jwoc101/Semaforo-Vehicular-y-Peatonal/diagramas/Diagrama_reloj_555.pdf

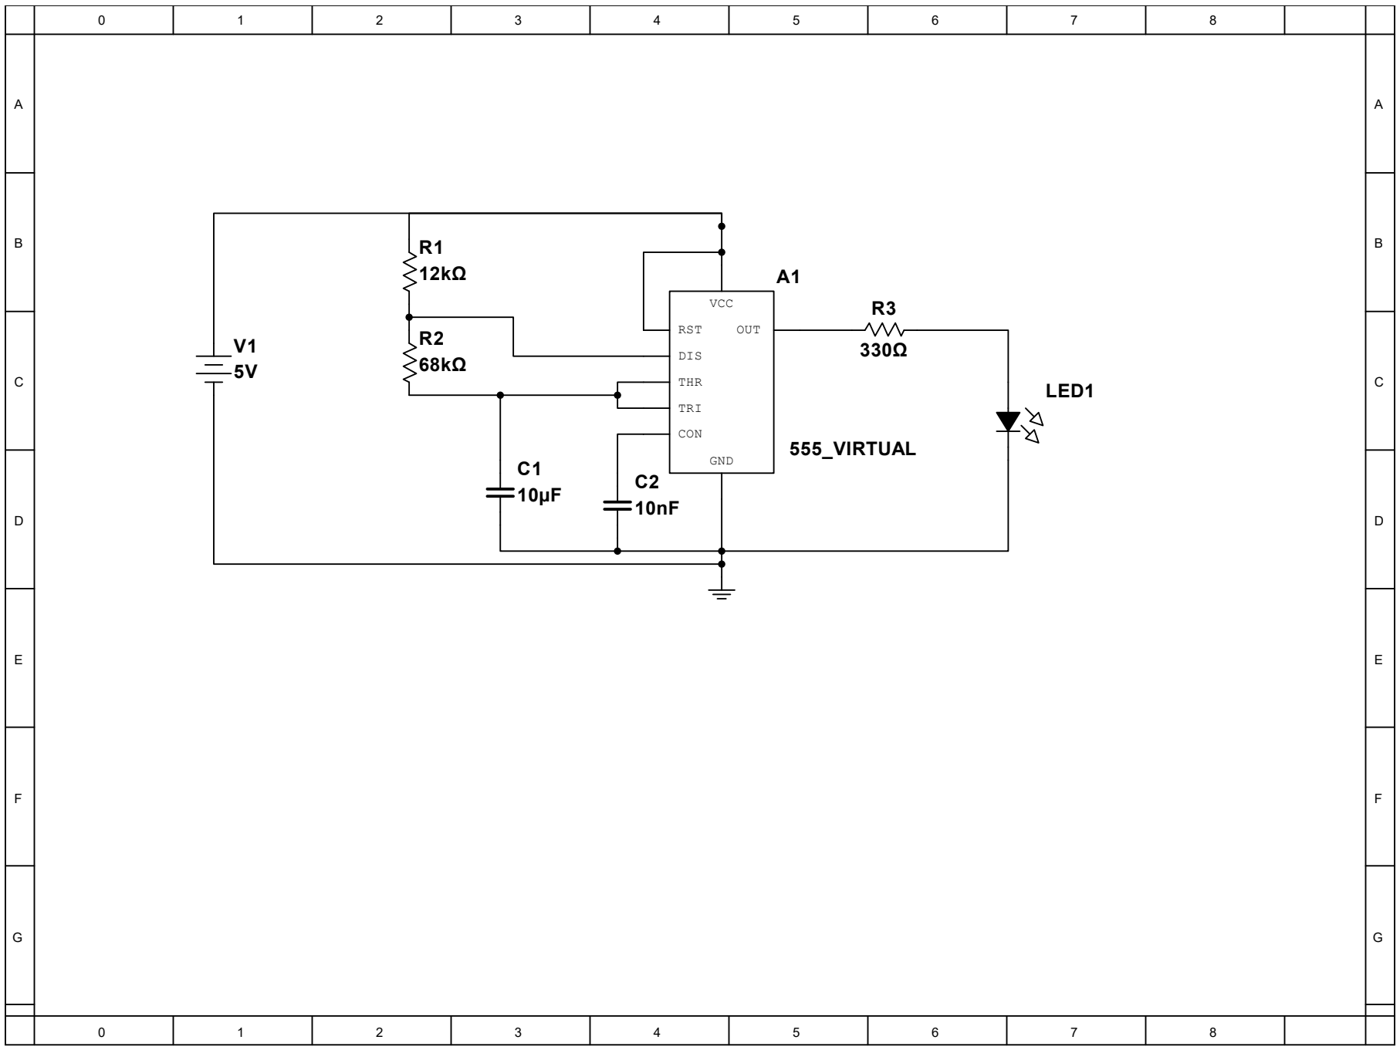
[picture p33: figure]
555_VIRTUAL; GND; DIS; RST; OUT; VCC; THR; CON; TRI; LED1
