jwoc101/Semaforo-Vehicular-y-Peatonal/Informe_Diseño/Informe_Diseño1.pdf

EL3215 LABORATORIO DE ELECTRÓNICA ANALÓGICA, IS2026 | 1

# Proyecto Final: Semáforo Vehicular y Peatonal

### Gabriel Alonso Chavarría Rodríguez José Andrés Guerrero Araya Julián Murillo Wo Ching Jimena Vargas Vega

Resumen

Resumen del proyecto.

Index Terms

Semáforo, FSM, temporización, lógica digital, electrónica analógica.

I. INTRODUCCIÓN
Texto de introducción.

II. PROPUESTA DE DISEÑO
II-A. Subsistema de Control y Temporización
II-A1. Reloj con Temporizador 555: Para el funcionamiento adecuado del sistema de control, y en general del proyecto, se requiere una señal de reloj que permita establecer una referencia de tiempo para los contadores y la máquina de estados. Por esta razón, se diseñó un circuito basado en el temporizador 555 en configuración astable, ya que esta configuración permite generar una señal cuadrada periódica sin necesidad de una señal externa de disparo.
La frecuencia de oscilación del 555 en modo astable se aproxima mediante [2]:

f =

1,44
(RA + 2RB)C

(1)

El objetivo fue obtener una frecuencia cercana a 1 Hz, de manera que cada ciclo de la señal represente aproximadamente un segundo dentro del sistema. Inicialmente se seleccionaron valores comerciales para las resistencias y el capacitor, y posteriormente se ajustó el valor de RA para acercar la frecuencia al valor deseado.
Los valores utilizados fueron:
RA = 12 kΩ
RB = 68 kΩ
C = 10 µF
Sustituyendo estos valores en la ecuación:

f =

1,44
(12kΩ + 2(68kΩ))(10µF)

(2)

f ≈ 0,973 Hz | (3)

Por lo tanto, el período aproximado es:

T =

1
f
≈ 1,03 s | (4)

Este valor se considera adecuado para la propuesta de diseño, ya que se encuentra cercano a 1 Hz y permite utilizar la salida del 555 como reloj base del sistema. La salida del temporizador se conecta a un LED únicamente como indicador visual durante la simulación (Figura 1).

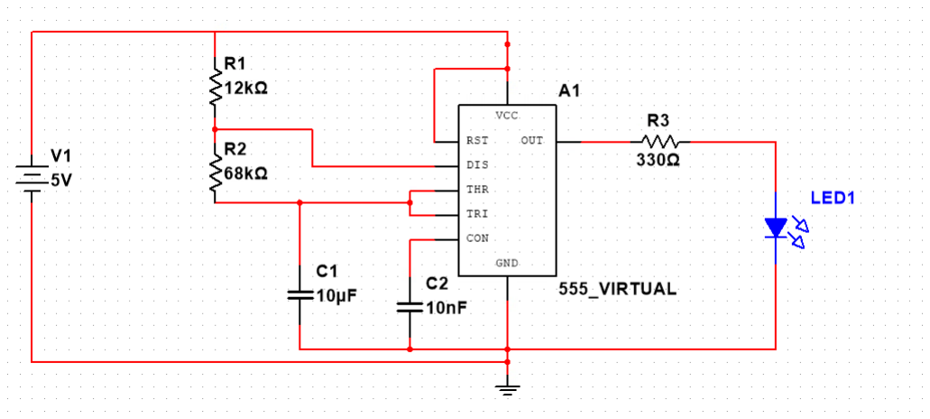
[picture p34: figure]

Figura 1. Circuito del reloj de aproximadamente 1 Hz implementado con temporizador 555 en configuración astable.

II-A2. Botón y Antirrebote: El botón peatonal funciona como la entrada principal externa hacia el sistema de control. Básicamente su activación acciona toda la lógica de ambos semáforos y sistemas asociados por medio de la máquina de estados. Sin embargo, los pulsadores mecánicos pueden generar rebotes no deseados durante su accionar, provocando así múltiples transiciones rápidas aunque solo se haya presionado el botón una vez. Para evitar que la máquina de estados interprete una sola pulsación como varias solicitudes, se implementó un circuito de antirrebote. El circuito utiliza una red RC formada por una resistencia de pull-down y un capacitor conectado a tierra. Esta red suaviza las variaciones rápidas producidas por el rebote mecánico del pulsador. Los valores seleccionados fueron:
R = 10 kΩ
C = 100 nF
La constante de tiempo de la red RC se calcula como:
τ = RC | (5)

Sustituyendo los valores utilizados:

τ = (10kΩ)(100nF) | (6)
τ = 1 ms | (7)

Posteriormente, la señal pasa por dos inversores Schmitt Trigger del circuito integrado 74LS14D (Figura 2). El primer inversor convierte la señal suavizada en una señal digital estable, mientras que el segundo inversor se utiliza para recuperar la polaridad original. De esta forma, la salida final, denominada BTN_CLEAN, toma un valor lógico alto cuando el botón es presionado y un valor lógico bajo cuando se encuentra liberado. En resumen, este módulo genera una salida llamada BTN_CLEAN que será usada a partir de ahora para referirse a la señal limpia del botón.

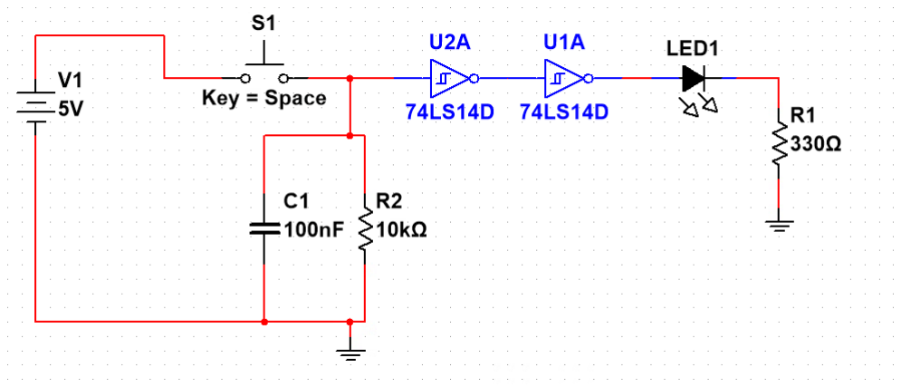
[picture p35: figure]

Figura 2. Circuito de entrada del botón peatonal con red RC y compuertas Schmitt Trigger.

II-A3. FSM: Texto.
II-A4. Memoria del botón: La memoria del botón surge a partir de una consideración importante del sistema: ¿qué ocurre si el botón peatonal se presiona mientras el semáforo ya se encuentra en media secuencia? Para evitar que una nueva pulsación altere el funcionamiento del sistema en la máquina de estados, se decidió que el botón solamente debe ser aceptado cuando la misma s se encuentra en el estado inicial S0, ya que solamente aquí habría una necesidad real de cruzar.
La codificación de estados considerada para la máquina de estados es la siguiente:

Cuadro I
CODIFICACIÓN DE ESTADOS DE LA FSM.
Estado | Q1 | Q0
S0 | 0 | 0
S1 | 0 | 1
S2 | 1 | 0
S3 | 1 | 1

Como el único estado en el que se desea aceptar el botón es S0, se implementó una señal de habilitación llamada S0_ACTIVE. Esta señal debe ser igual a 1 únicamente cuando Q1 = 0 y Q0 = 0. Para lograr esto se utilizó una compuerta NOR 74LS02, ya que:

S0_ACT IV E = Q1 + Q0 | (8)

De esta forma, cuando el sistema se encuentra en S0, la salida de la NOR se activa. En cualquier otro estado, la señal permanece en cero.
Luego, la señal S0_ACTIVE se combina con la salida limpia del botón (BTN_CLEAN). Esta combinación genera la señal REQUEST_VALID, la cual indica que existe una solicitud peatonal válida:
REQUEST_V ALID = S0_ACT IV E · BT N_CLEAN | (9)

Para implementar esta operación lógica se utilizó una compuerta AND 74LS08. La Tabla II muestra el comportamiento esperado cuando el botón se encuentra presionado, es decir, cuando
BTN_CLEAN = 1.

Cuadro II
VALIDACIÓN DEL BOTÓN PEATONAL SEGÚN EL ESTADO ACTUAL.
Q1 | Q0 | Estado | S0_ACTIVE | BTN_CLEAN | REQUEST_VALID
0 | 0 | S0 | 1 | 1 | 1
0 | 1 | S1 | 0 | 1 | 0
1 | 0 | S2 | 0 | 1 | 0
1 | 1 | S3 | 0 | 1 | 0

En esta tabla, Q1 y Q0 representan los bits del estado actual de la FSM. La señal S0_ACTIVE confirma que el sistema está en el estado inicial. La señal BTN_CLEAN corresponde a la salida del circuito antirrebote del botón peatonal. Finalmente, REQUEST_VALID indica que la solicitud debe ser aceptada por el sistema.
Una vez generada la señal REQUEST_VALID, es necesario almacenarla, ya que se podría soltar el botón antes de que la FSM procese la solicitud. Para esto se utilizó un flip-flop D 74LS74. La entrada D se conectó a nivel lógico alto, mientras que la señal REQUEST_VALID se conectó al reloj del flip-flop. De esta forma, cuando ocurre un flanco positivo en REQUEST_VALID, el flip-flop almacena un 1 en su salida Q.
La salida Q del flip-flop se denomina T B. Esta señal permanece en 1 aunque el botón sea liberado, indicando que existe una solicitud peatonal pendiente. Posteriormente, esta memoria se reinicia mediante la señal de reset proveniente de la FSM, haciendo que T B vuelva a cero una vez que la solicitud ha sido atendida.
La configuración utilizada para el 74LS74 fue la siguiente [1]:
Entrada D conectada a 5 V .
Entrada de reloj conectada a REQUEST_VALID.
Salida Q utilizada como T B.
Entrada CLR conectada a la señal de reinicio de la FSM.
Entrada PR conectada a nivel lógico alto para mantenerla inactiva.
En la Fig. 3 se muestra la implementación completa del bloque de validación y memoria del botón peatonal.

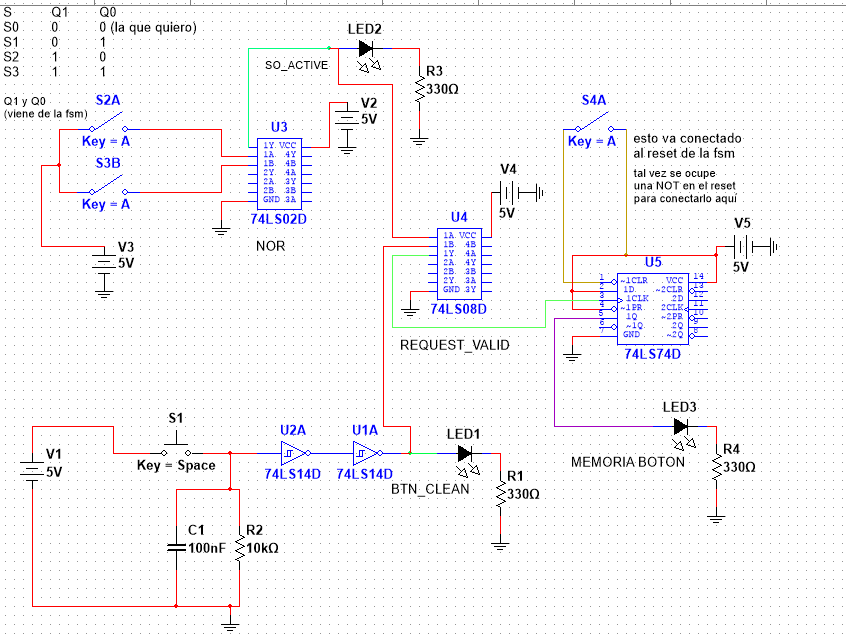
[picture p36: figure]

Figura 3. Circuito de validación y memoria de la solicitud peatonal.

III. SIMULACIONES
III-A. Simulación de algo

IV. CONCLUSIONES
Conclusión 1.
Conclusión 2.
Conclusión 3.

REFERENCIAS

[1] Texas Instruments, “SN74LS74A Dual D-Type Positive-Edge-Triggered Flip-Flops With Preset and Clear Datasheet,” Dallas, TX, USA. [Online]. Available: https://c1555f5ec9.clvaw-cdnwnd.com/34662fcf1f1e607c561442431023ac8e/200000751-dcad7dda84/74LS74%20Datasheet.pdf (https://c1555f5ec9.clvaw-cdnwnd.com/34662fcf1f1e607c561442431023ac8e/200000751-dcad7dda84/74LS74%20Datasheet.pdf)
[2] Electrónica FP, “555 Astable,” YouTube, 2021. [Online]. Available: https://www.youtube.com/watch?v=OKDaA-yE2QY [3]
