jwoc101/Semaforo-Vehicular-y-Peatonal/Informe_Diseño/fig_finales/Diagrama_completo_recortado.pdf

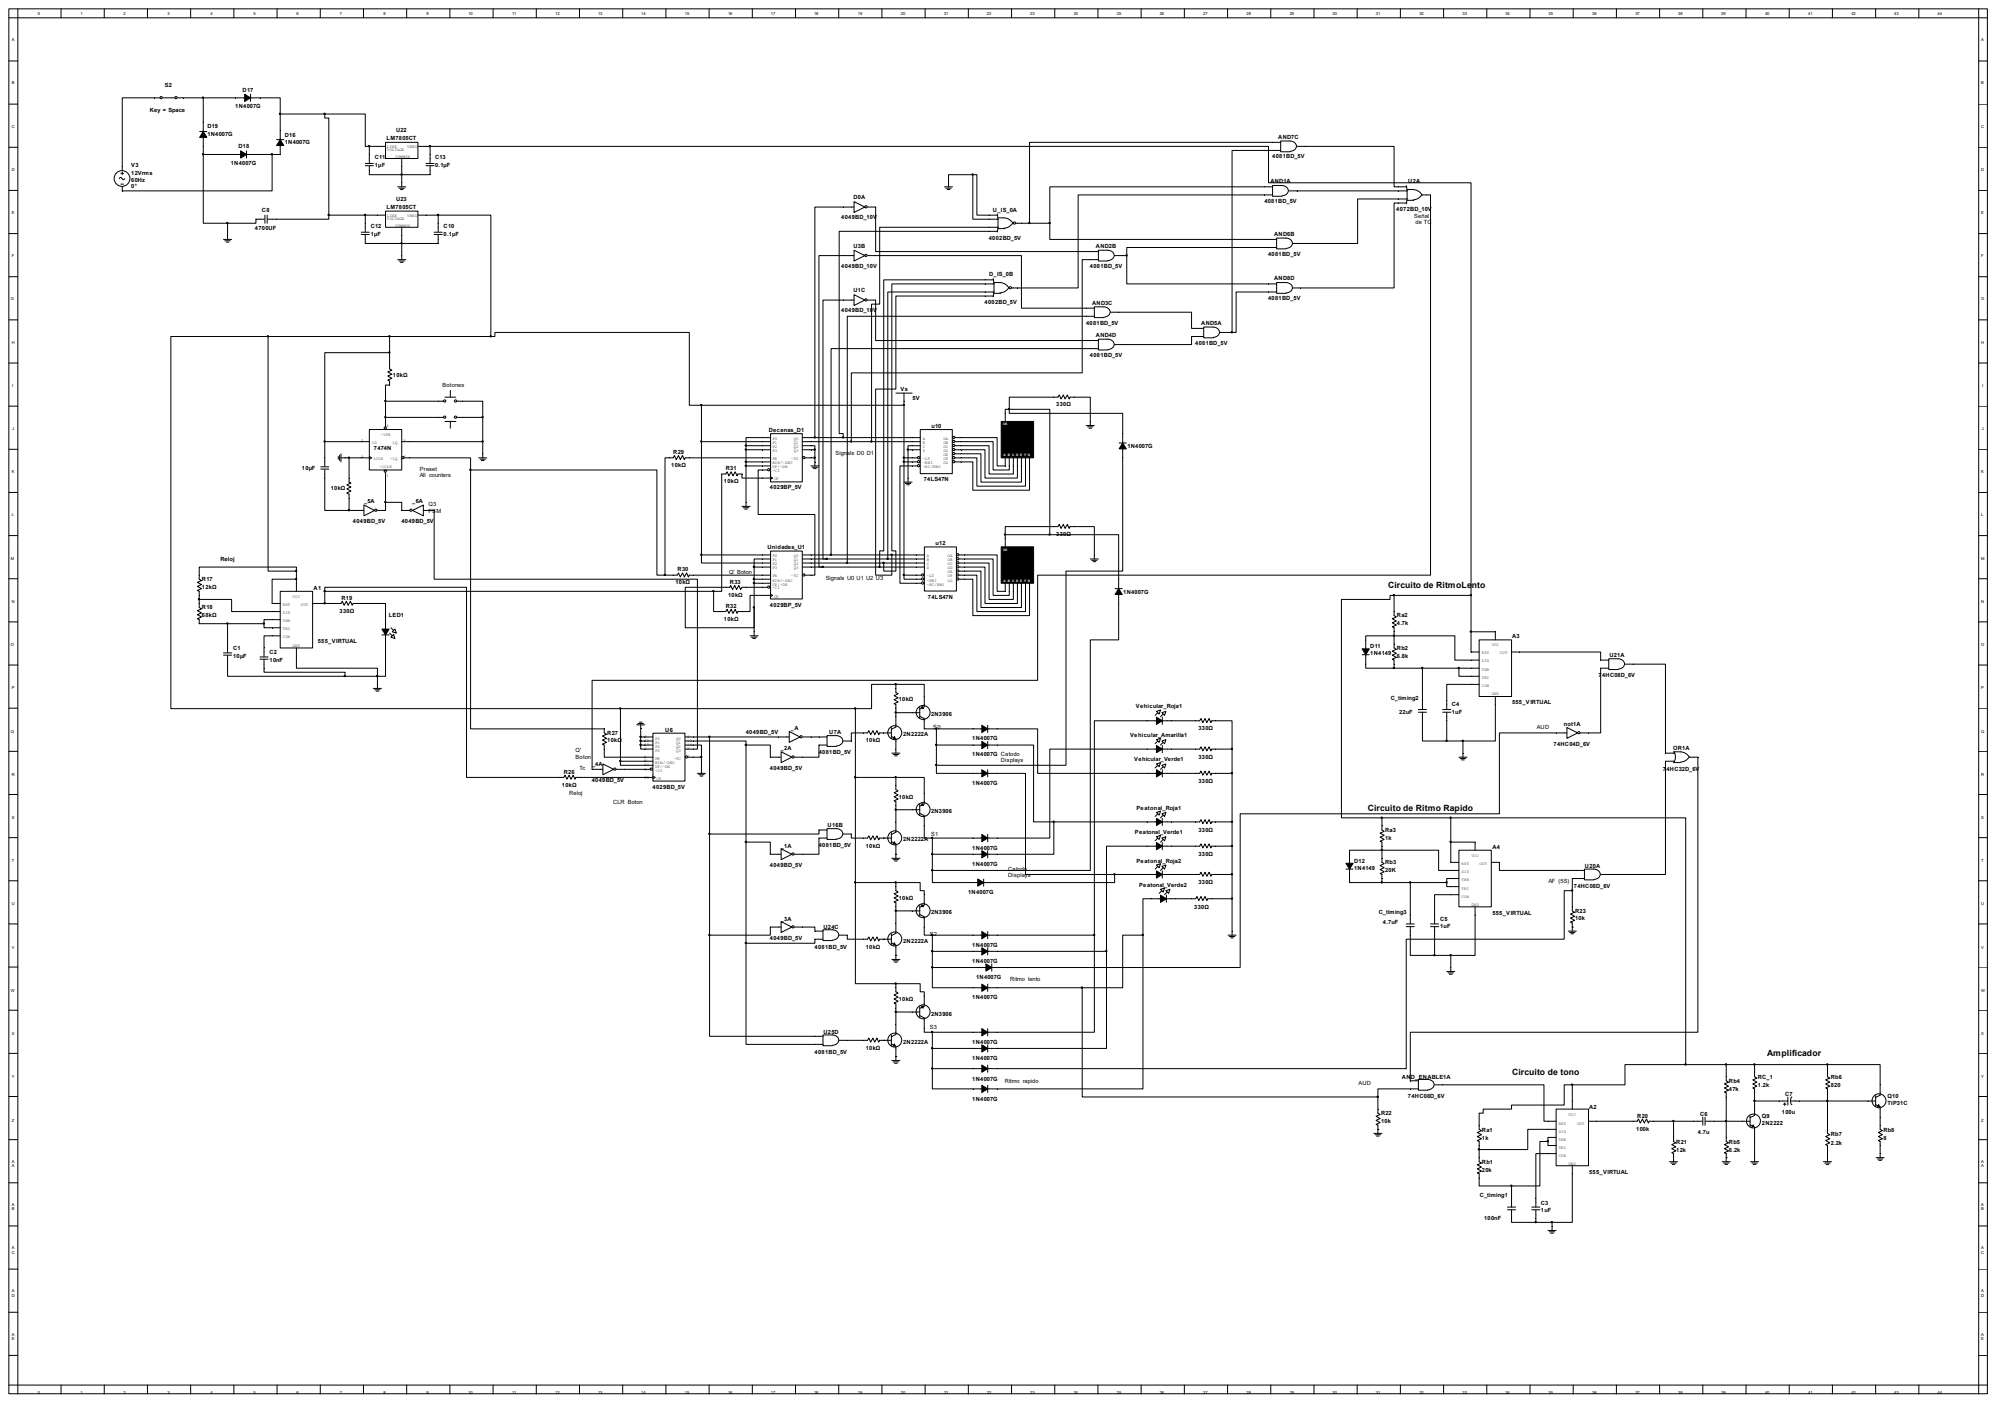
[picture p39: page 1]

Circuito de Ritmo Rapido
