jwoc101/Semaforo-Vehicular-y-Peatonal/diagramas/Diagrama_completo.pdf

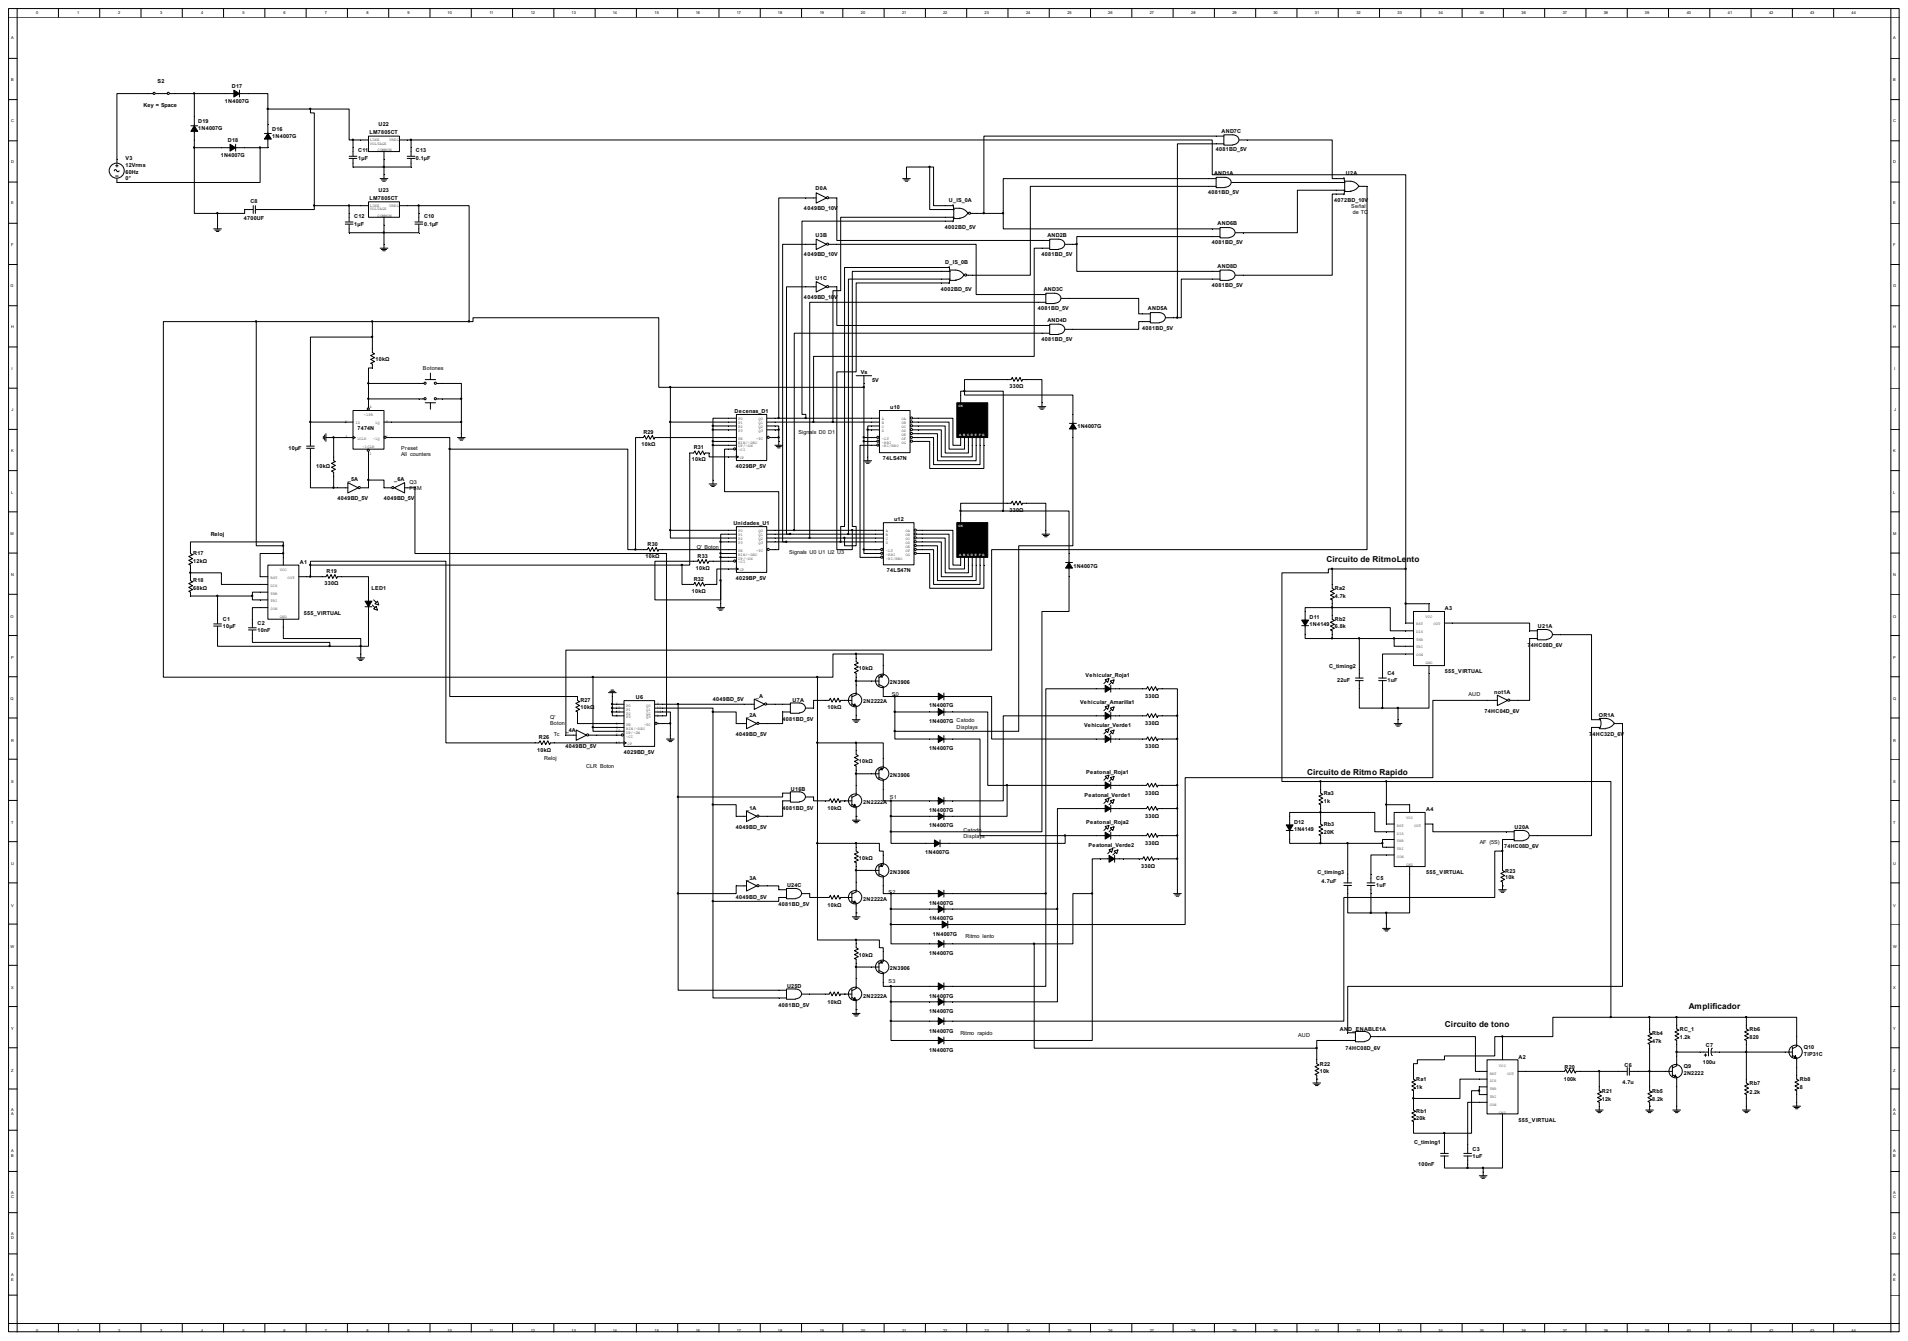
[picture p40: page 1]

Circuito de Ritmo Rapido
