jwoc101/Semaforo-Vehicular-y-Peatonal/diagramas/Audio_v2.pdf

## Circuito de Ritmo lento

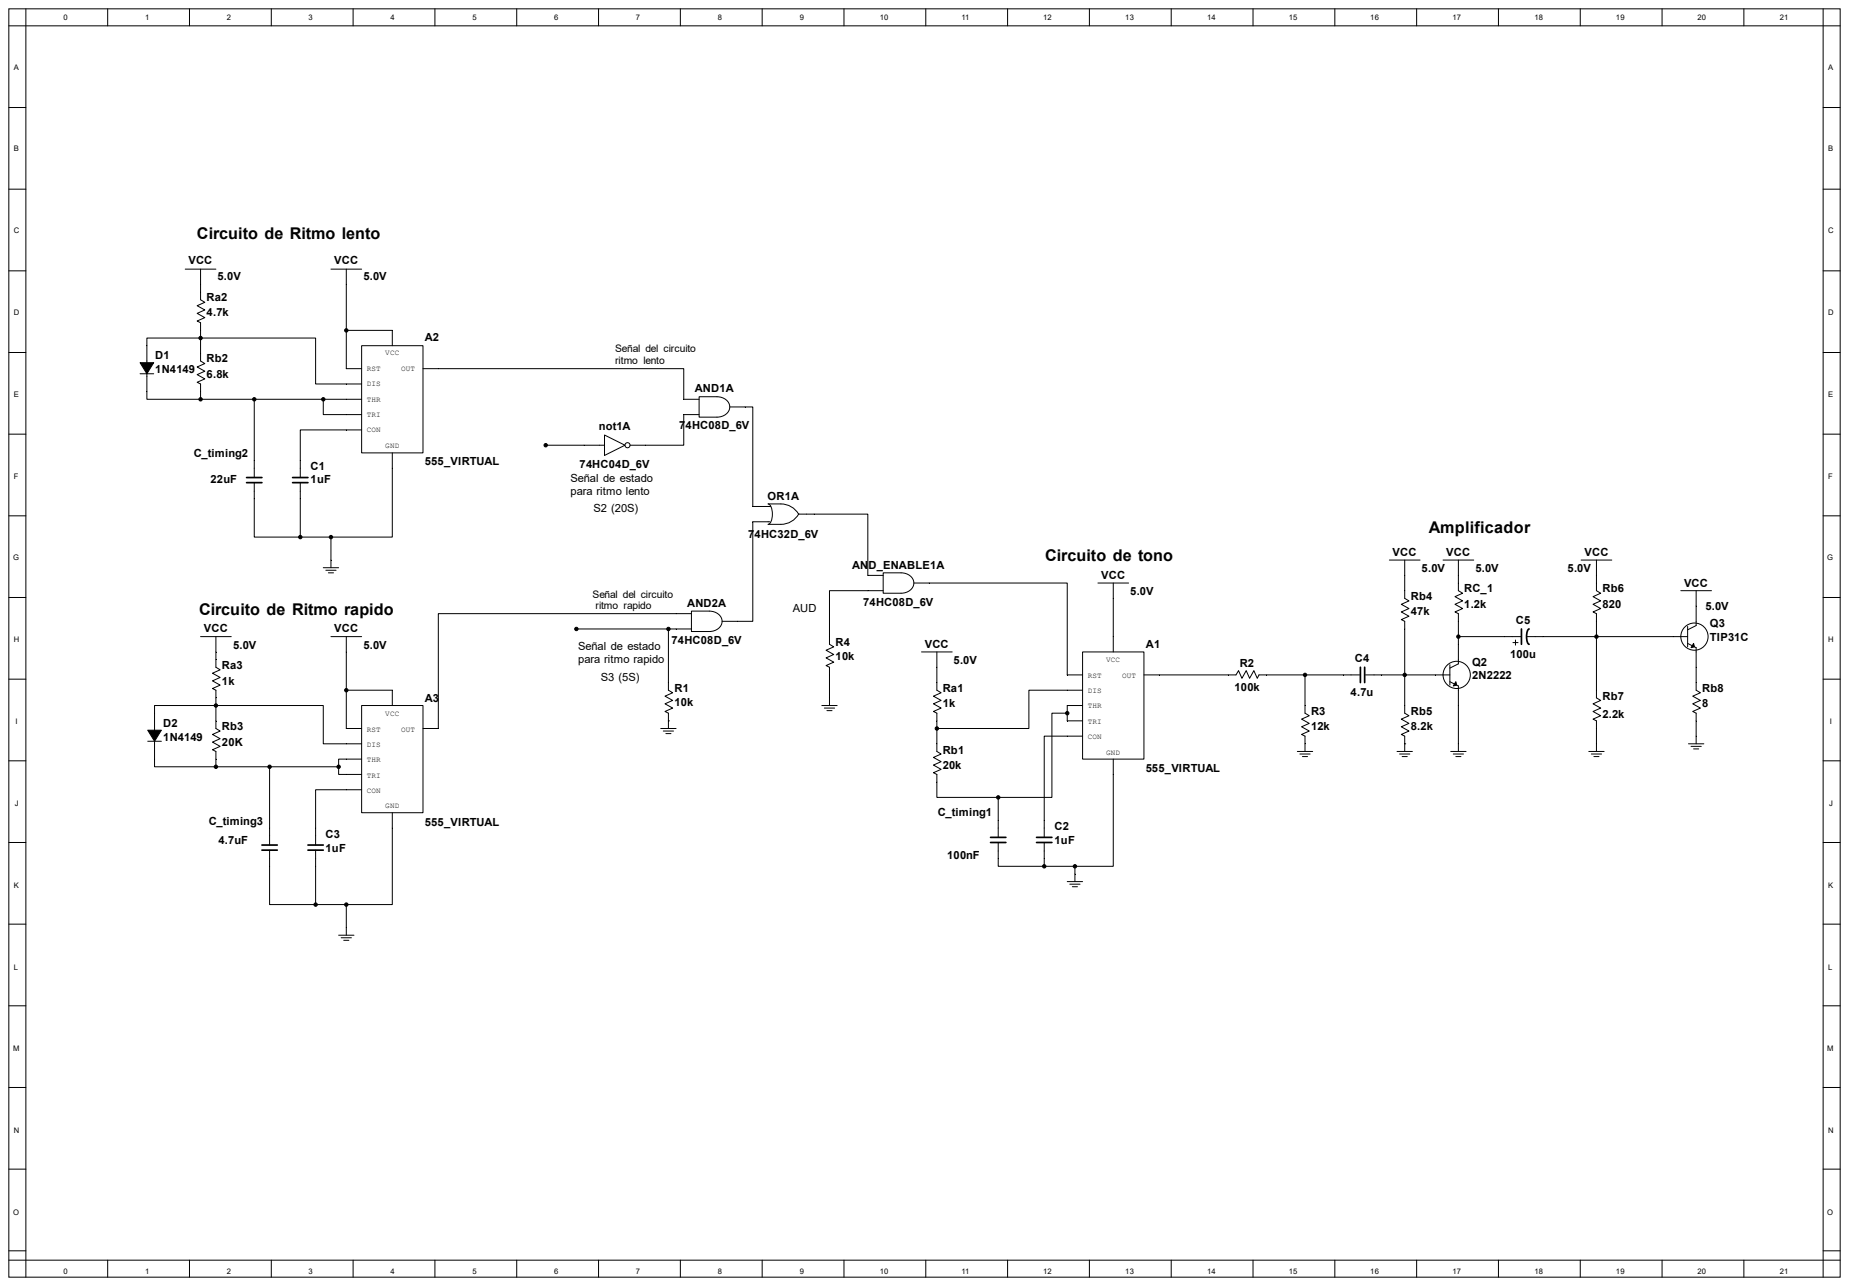
[picture p41: page 1]
