jwoc101/Semaforo-Vehicular-y-Peatonal/diagramas/Diagrama_Boton.pdf

## Vs 5V

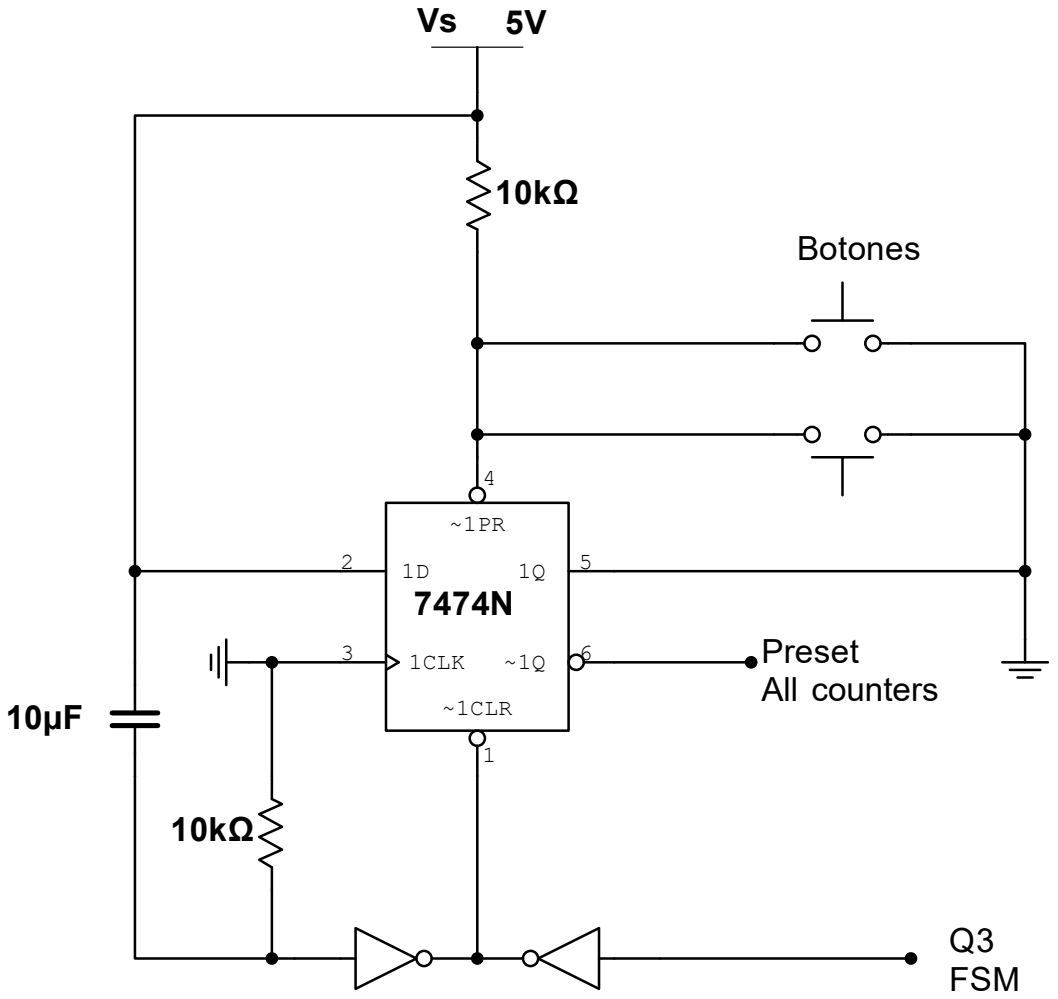
[picture p42: page 1]
~1CLR; 1CLK 3; Q3 FSM; Preset All counters; Botones
