jwoc101/Semaforo-Vehicular-y-Peatonal/diagramas/Diagrama_fuente.pdf

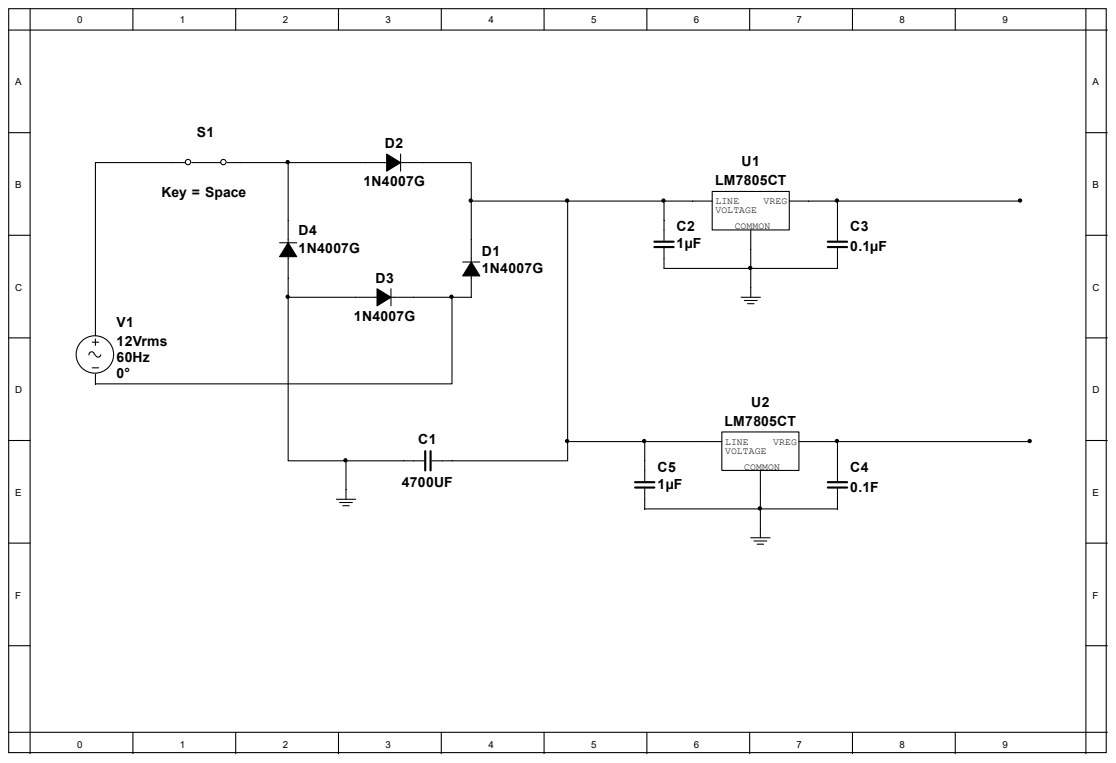
[picture p43: page 1]
