jwoc101/Semaforo-Vehicular-y-Peatonal/diagramas/Diagrama_Display.pdf

Vs

S1, S0

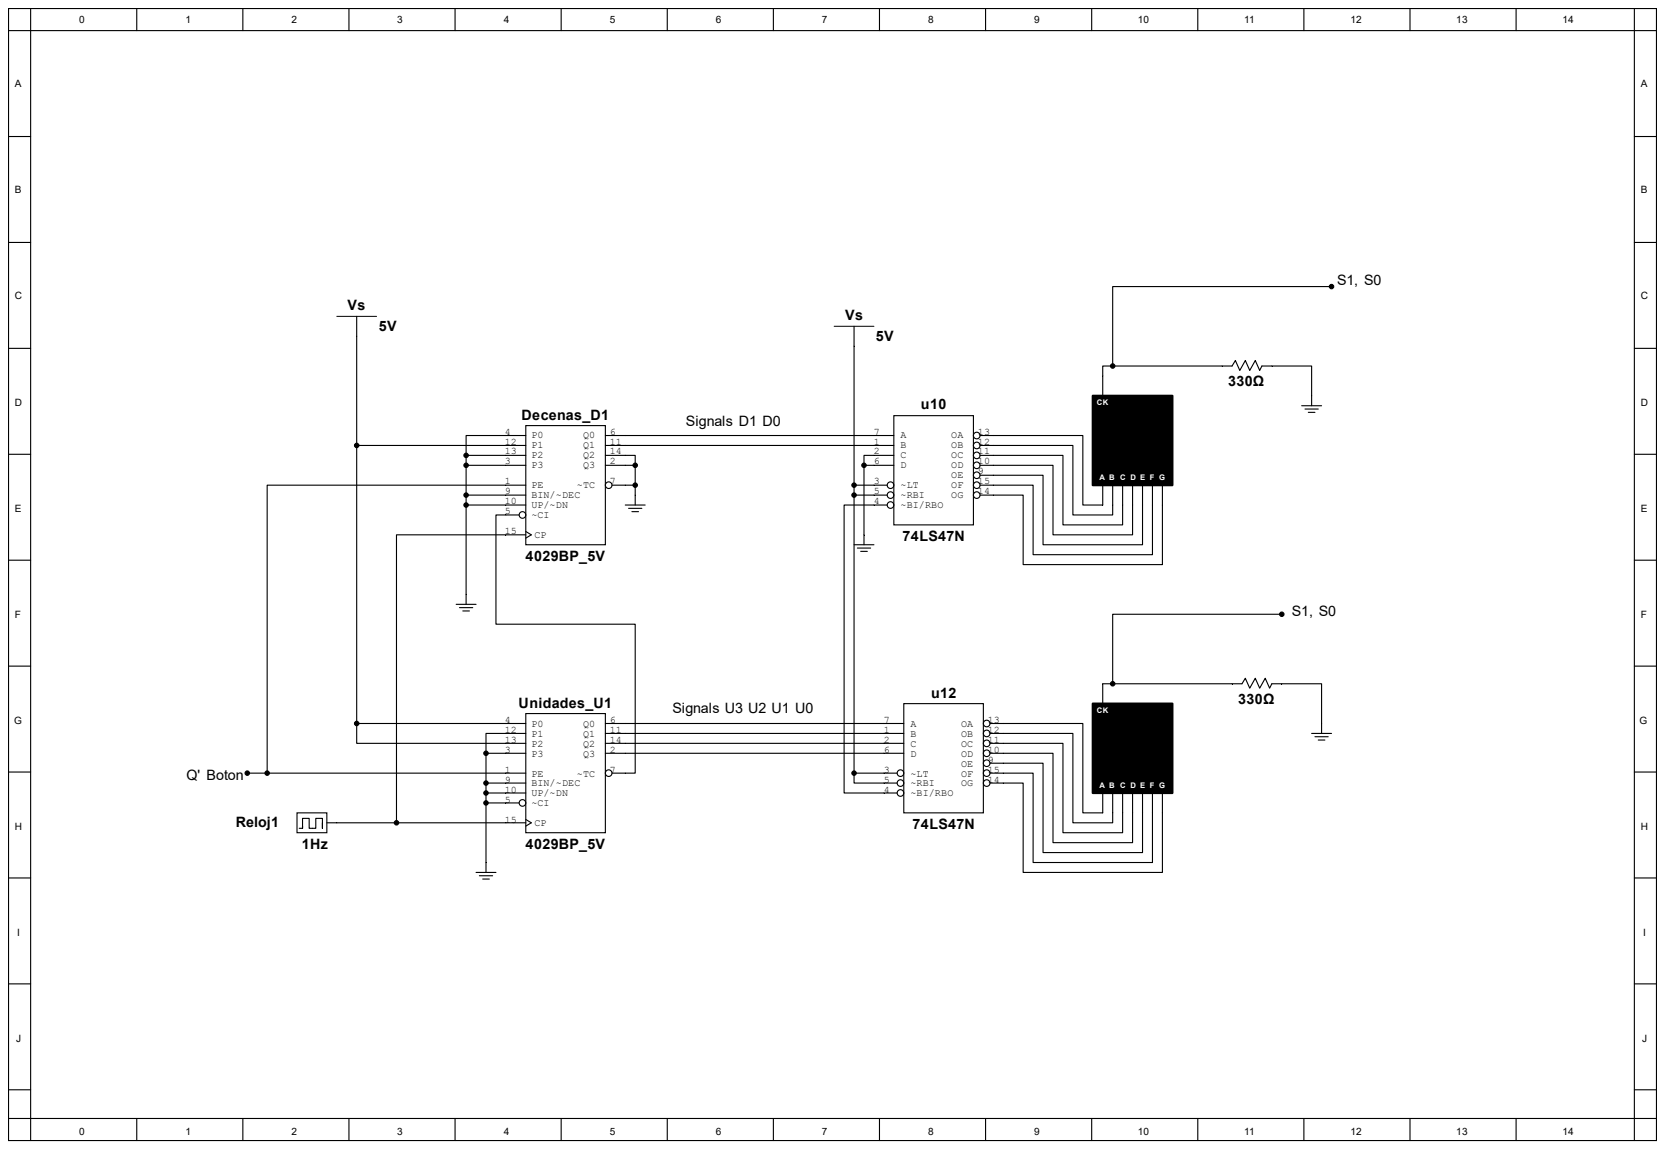
[picture p44: page 1]
