jwoc101/Semaforo-Vehicular-y-Peatonal/diagramas/Diagrama_FSM.pdf

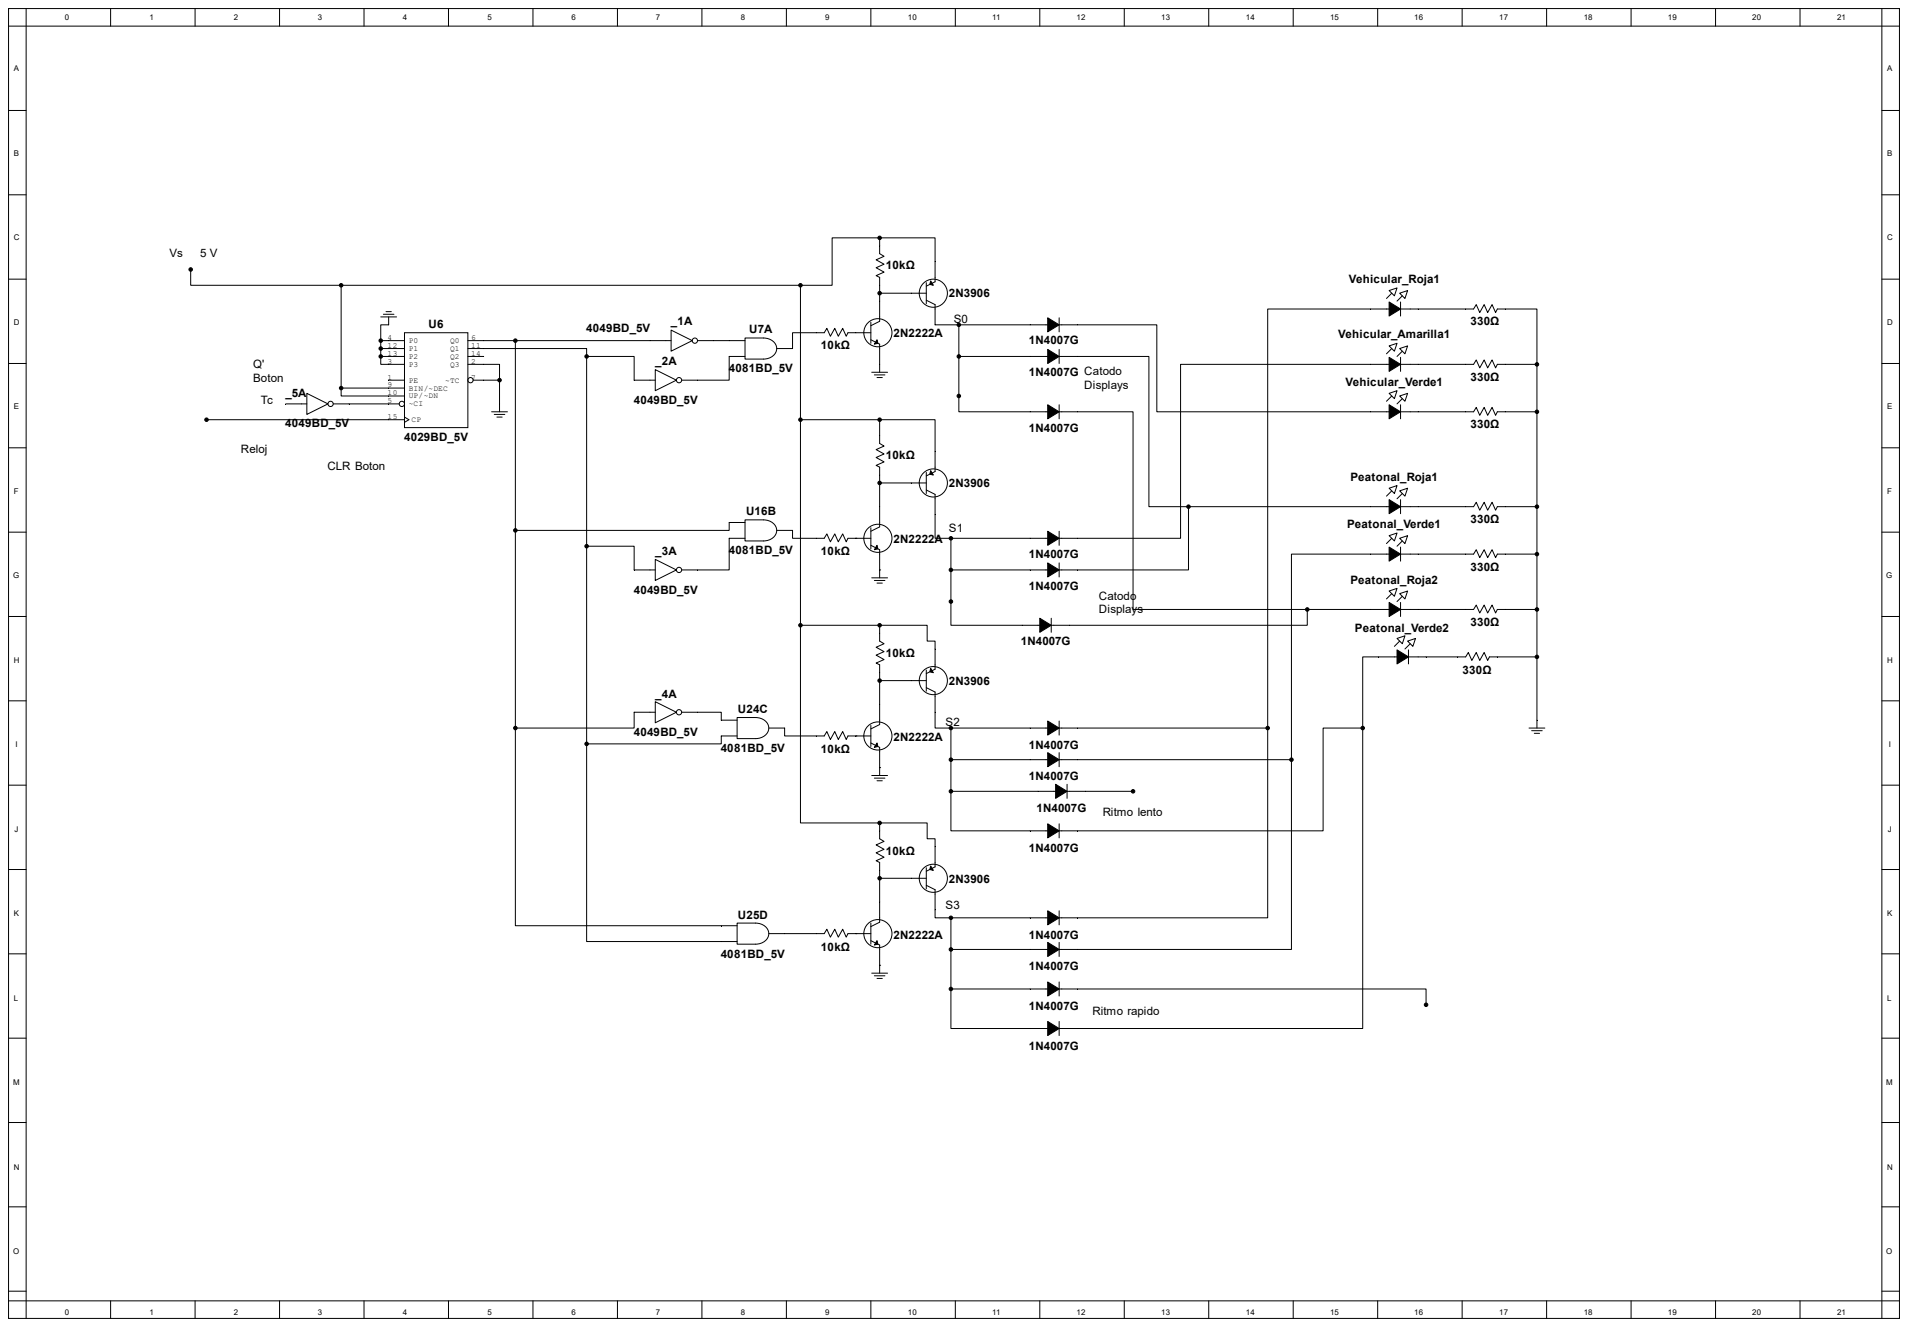
[picture p45: page 1]
