jwoc101/Semaforo-Vehicular-y-Peatonal/diagramas/Diagrama_TC_Display.pdf

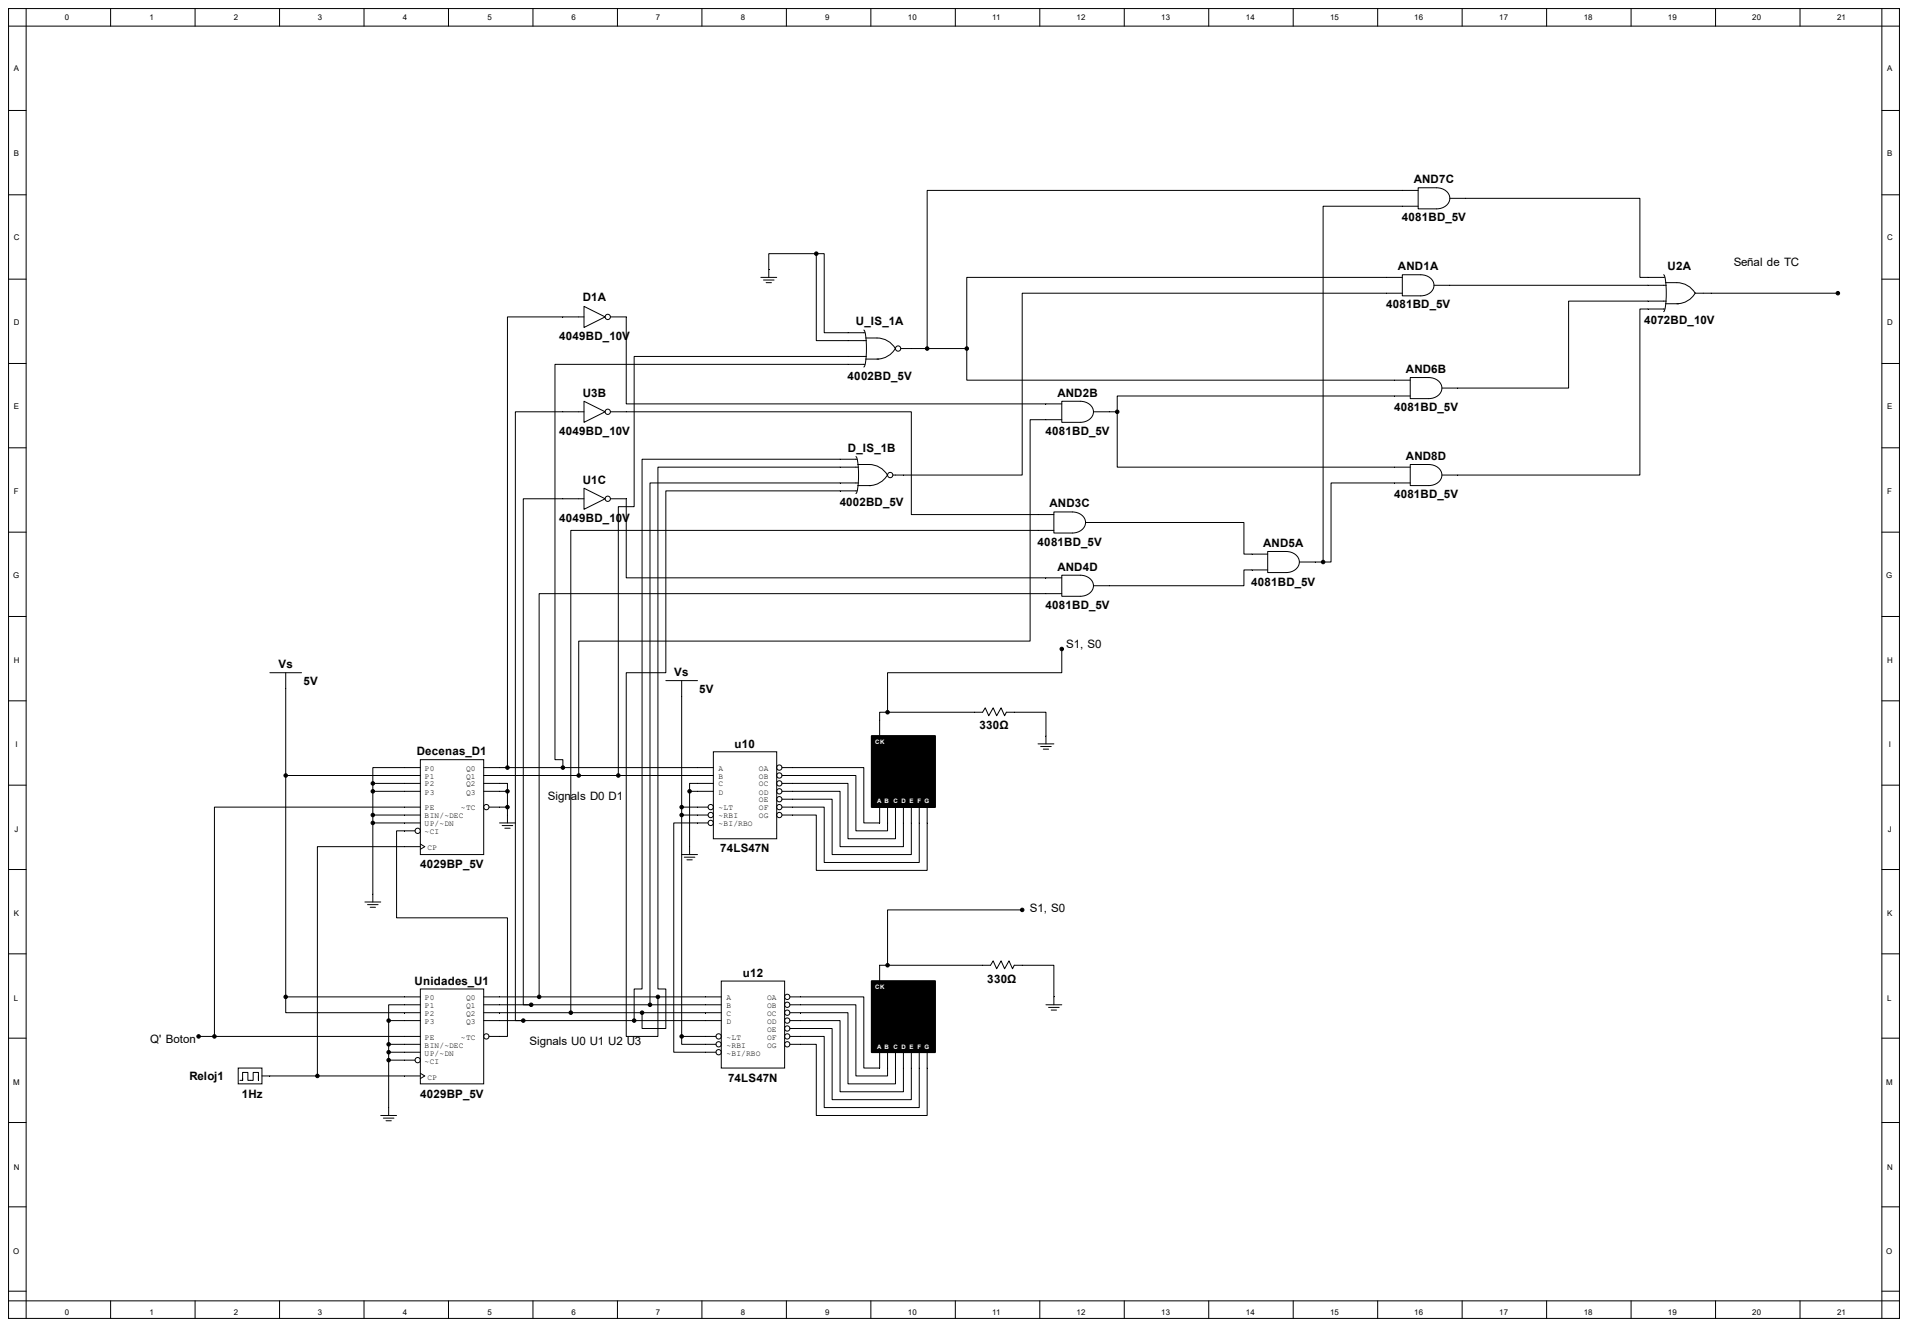
[picture p46: page 1]
