jwoc101/Semaforo-Vehicular-y-Peatonal/diagramas/Audio.pdf

## Circuito de Ritmo lento

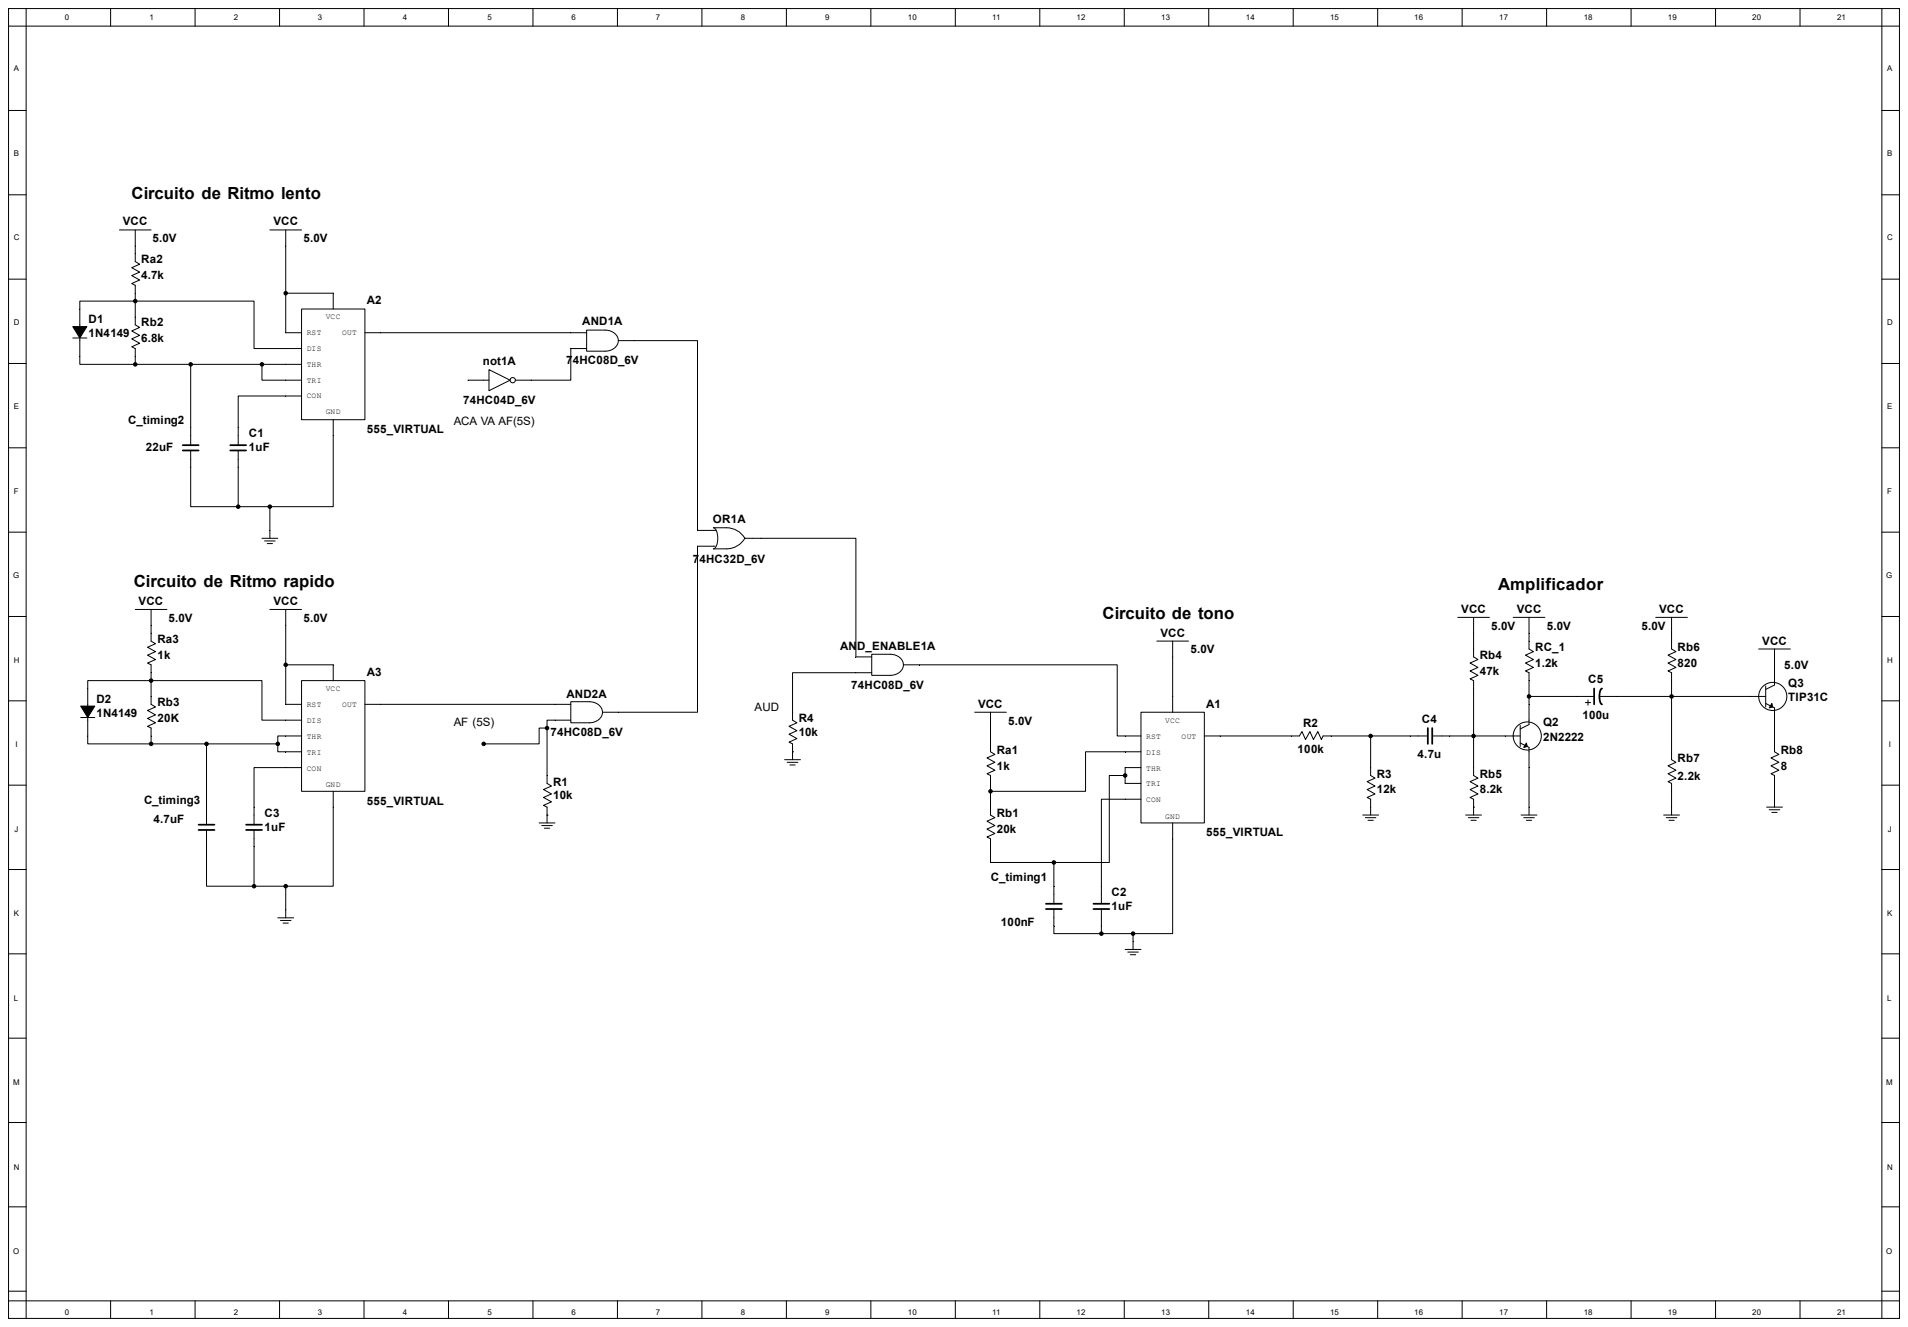
[picture p47: page 1]
