jwoc101/Semaforo-Vehicular-y-Peatonal/(list of files, drawings)

Other design files:
diagramas/Audio.ms14
diagramas/Boton.ms14
diagramas/Circuito_completo_v2.ms14
diagramas/Display.ms14
diagramas/FSM Grafico.ms14
diagramas/Fuente.ms14
diagramas/TC_Display.ms14
Graficos_Final/Boton Grafico.ms14
Graficos_Final/Circuito_completo_v2.ms14
Graficos_Final/Diagrama_Reloj_555.ms14
Graficos_Final/Displays Grafico.ms14
Graficos_Final/FSM Grafico.ms14
Graficos_Final/fuente_correcta.ms14
Graficos_Final/TC_Display.ms14
