jwoc101/Semaforo-Vehicular-y-Peatonal/(commit log)

2026-05-20 Añadir template de propuesta y .gitignore
2026-05-21 Agregar carpeta Subsistema de Audio
2026-05-21 Restaurar archivos de audio y renombrar carpeta a Subsistema_Audio
2026-05-23 Añadir Contador_FSM y ordenar directorio de alimentación
    [Contador_FSM_con_display.ms14, Semaforo_Peatonal_Contador.ms14]
2026-05-23 Agregar subsistema de audio al informe: circuitos 555, amplificador, figuras y referencias IEEE
2026-05-23 Cambios locales de Jimena
2026-05-23 Creación de branch personal. Update a informe con subsistemas
    [Circuito_Final_Audio.ms14, Contador_FSM_con_display.ms14, N555_de_Tono.ms14, RitmoLento.ms14, RitmoRapido.ms14, Subsistema_Audio_Completo.ms14]
2026-06-25 Gráfico de la FSM
    [FSM Grafico.ms14]
2026-06-25 Creacion de folder
2026-06-25 Actualiza build del informe y agrega archivos de Multisim
    [Bloque_1_Reloj.ms14, Bloque_2_Boton_Antirrebote.ms14, Bloque_3_Memoria_Boton.ms14, Circuito_Contadores_Julian.ms14, Circuito_Final_Audio.ms14, Contador_FSM_con_display.ms14, N555_de_Tono.ms14, RitmoLento.ms14]
2026-06-25 Agrega diagrama del reloj 555
    [Diagrama_Reloj_555.ms14]
2026-06-28 Actualiza circuito completo y corrige FSM y fuente
    [Circuito_Contadores_Julian.ms14, Circuito_completo_v2.ms14, TC_Display.ms14, fuente.ms14, fuente_correcta.ms14]
2026-06-29 Update de Informe Final
2026-06-30 Reorganizar carpeta
    [Bloque_1_Reloj.ms14, Bloque_2_Boton_Antirrebote.ms14, Bloque_3_Memoria_Boton.ms14, Circuito_Final_Audio.ms14, Contador_FSM_con_display.ms14, N555_de_Tono.ms14, RitmoLento.ms14, RitmoRapido.ms14]
2026-06-30 parte de diagramas y carpetas correctas
    [Audio.ms14, Boton.ms14, Circuito_Final_Audio_Diagrama.ms14, Circuito_completo_v2.ms14, Diagrama_Memoria_Boton.ms14, Diagrama_Reloj_555.ms14, Display.ms14, Displays Grafico.ms14]
2026-06-30 Reemplazar imágenes de simulación por diagramas finales
    [Fuente.ms14]
2026-06-30 descripción breve de lo que cambiaste
2026-07-01 Reorganizar: mover Informe_Final.tex fuera de build/
2026-07-01 Agregar diagramas de audio y reorganizar carpeta Graficos_Final
    [Boton Grafico.ms14, Circuito_completo_v2.ms14, Diagrama_Reloj_555.ms14, Displays Grafico.ms14, FSM Grafico.ms14, TC_Display.ms14, fuente_correcta.ms14]
2026-07-01 Diagrama de bloques general del sistema
2026-07-01 Agrega secciones T_C y Estados, corrige labels e imagenes de FSM
2026-07-01 Diagramas de Bloques General y FSM
2026-07-01 Avances en Informe_Final y actualización de diagramas
2026-07-01 Reubicación de diagramas
2026-07-01 cambion en el resumen
2026-07-01 no se que es
2026-07-01 parte de proto y anexos
    [Circuito_completo_v2.ms14]
